ninjahisser/JJMP3/hardware/case.3mf

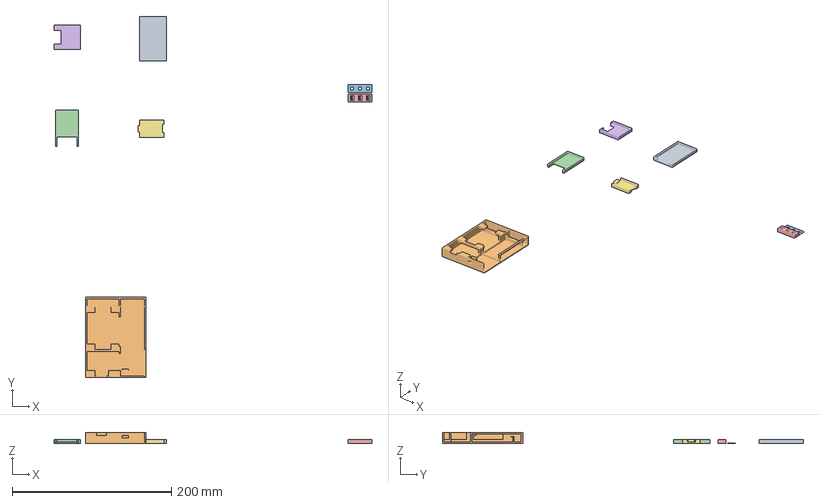
[picture p5: CAD file, 2026-11-09]
hardware/case.3mf
399.9 x 454.1 x 14.0 mm
case_esp32.stl
case_bottom.stl
case_ButtonsLid.stl
case_SD.stl
case_ButtonsRow.stl
case_display.stl
case_tp4056.stl
