ninjahisser/JJMP3/hardware/case_bottom.stl

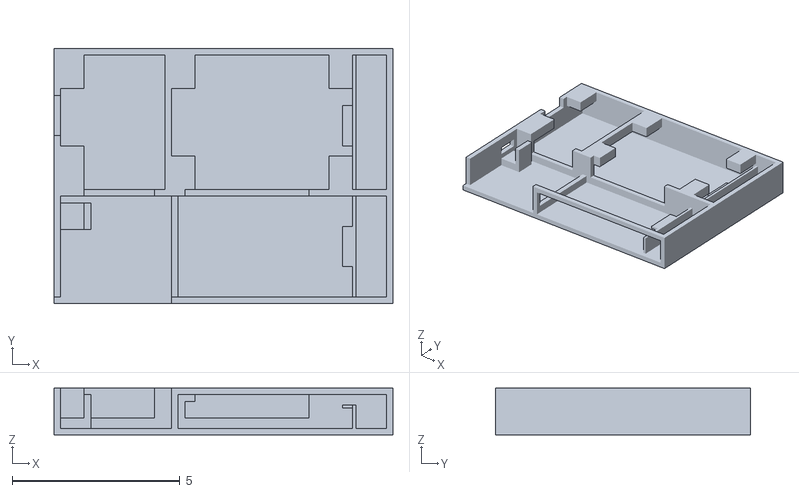
[picture p6: CAD file, 2026-11-09]
hardware/case_bottom.stl
10.1 x 7.60 x 1.40
