ninjahisser/JJMP3/hardware/case_tp4056.stl

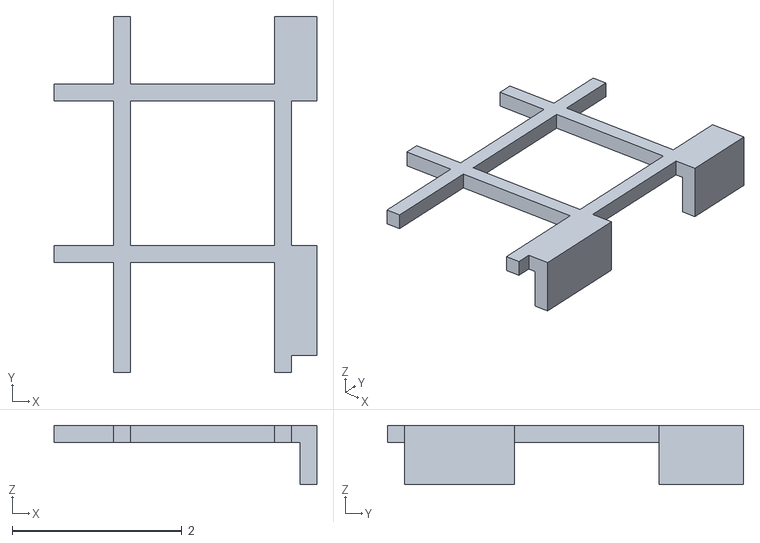
[picture p7: CAD file, 2026-11-09]
hardware/case_tp4056.stl
3.10 x 4.20 x 0.7
