ninjahisser/JJMP3/hardware/case_ButtonsRow.stl

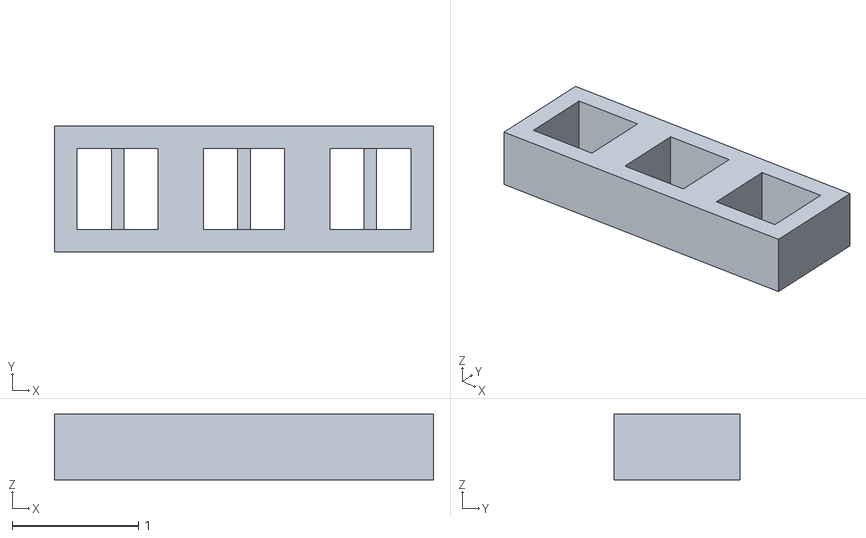
[picture p8: CAD file, 2026-10-25]
hardware/case_ButtonsRow.stl
3.00 x 1.00 x 0.52
