ninjahisser/JJMP3/hardware/case_ButtonsLid.stl

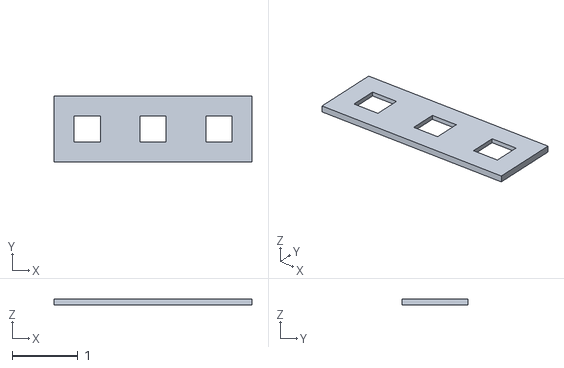
[picture p9: CAD file, 2026-10-24]
hardware/case_ButtonsLid.stl
3.00 x 1.00 x 0.09
