ninjahisser/JJMP3/hardware/case_SD.stl

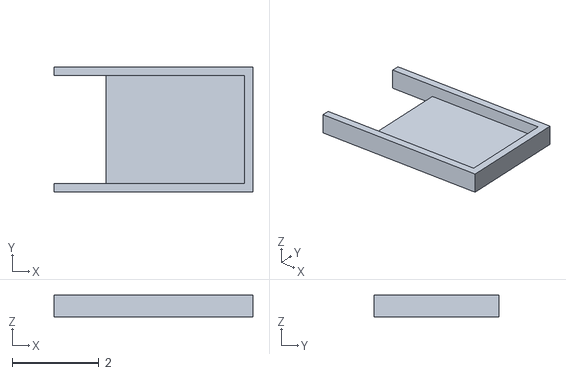
[picture p10: CAD file, 2026-10-21]
hardware/case_SD.stl
4.60 x 2.90 x 0.5
