ninjahisser/JJMP3/hardware/case_display.stl

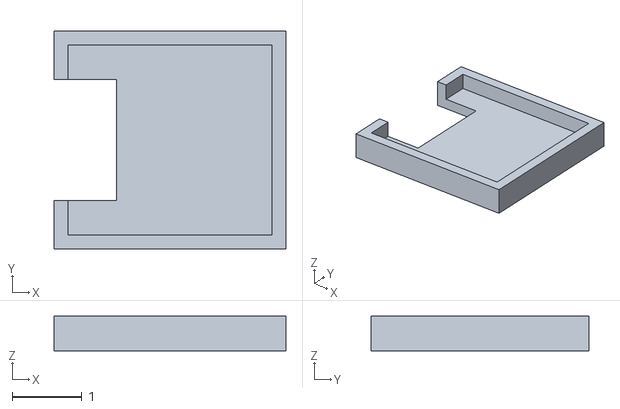
[picture p11: CAD file, 2026-10-21]
hardware/case_display.stl
3.33 x 3.13 x 0.5
