ninjahisser/JJMP3/hardware/case_esp32.stl

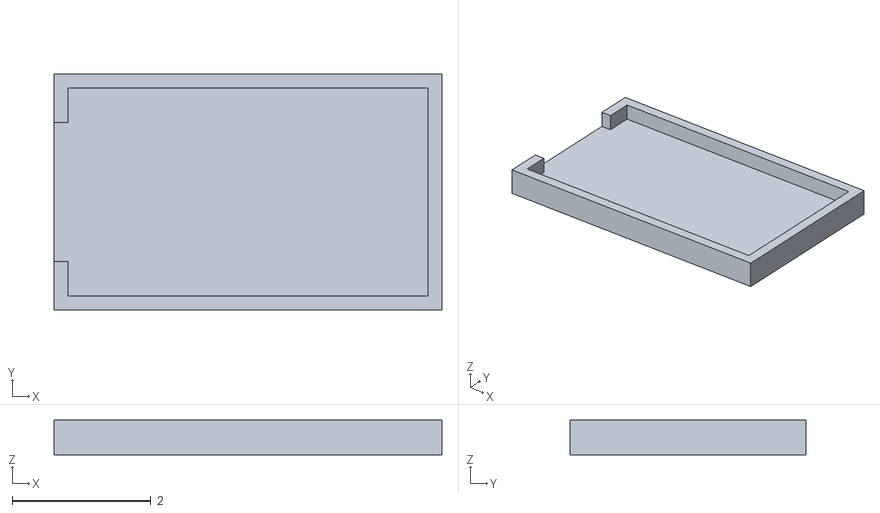
[picture p12: CAD file, 2026-10-21]
hardware/case_esp32.stl
5.60 x 3.40 x 0.5
