ninjahisser/JJMP3/(list of files, cad)

Other CAD files:
hardware/case.blend
