ninjahisser/JJMP3/todo.md

# Todo

Legend: ✅ checked by you and it works · 🔍 done, waiting for your review · ⬜ not done yet (reason in italics)

ik wil meerdere wifis kunnen opslaan gelijk een gsm

we moeten hebben: music player mode (normaal), spotify mode (spotify sync), en speaker mode (werkt als externe speaker met pc bv verbonden).

🔍 show battery percentage when playing on bluetooth. *Bottom right of Now Playing, when a battery is wired.*

⬜ Add audio even if its simple to all the games and UI. *Needs the speaker amplifier (ordered?) and the I2S audio code.*

⬜ on the device I should be able to add music to playlists and rename playlists etc like pc. *Not started.*

⬜ music playing should sync with the device, so playing a song, timeline etc is always the same and controls control both on both devices. *The app shows the player's state and the output switch hands over; full two-way sync is not done.*

🔍 when adding music and it shows a playlist, make it so I can select individual songs to add like a checkbox.

🔍 when I hover over teh app in the taskbar it should havce those controls like spotify does.

🔍 add karaoke mode in a tab. *Karaoke tab with synced lyrics, a saved timing offset per song, and a live search ("Wrong or missing lyrics? Search") to pick the right lyrics when the title doesn't match.* the device should also show the lyrics of the song. *Not done: needs the SD card.*
