ninjahisser/JJMP3/(commit log)

2026-10-18 JJMP3: ESP32 MP3 player firmware and desktop app
    - Firmware (firmware/jjmp3): SD card MP3 playback over Bluetooth A2DP,
    OLED now-playing screen with dithered cover art, one-button control,
    JSON protocol over USB serial and HTTP. Built as two images (music
    mode / Wi-Fi mode) because the ESP32 can't fit both radios in RAM.
    - Desktop app (app): imports YouTube and Spotify links, converts and
    uploads them to the player, playlists, playback control, live OLED
    mirror, Wi-Fi and Bluetooth setup. JJMP3.exe sets itself up on first run.
    - Wiring test sketches in firmware/tests.
2026-10-19 JJMP3 1.0.2: device OS, buttons, games, dark mode
    Player firmware 1.1.0:
    - iPod-style OS on the OLED: Now playing, Music, Playlists, Games, Settings
    (Bluetooth pairing, Wi-Fi scan / type a name, mode switch, About).
    - Five buttons (< P > and volume +/-) on D32 D4 D33 D13 D14; the app can
    press them remotely (btn command).
    - On-device keyboard: a character wheel driven by < P >.
    - Games: built-in Snake and a CHIP-8 player for .ch8 files in /games.
    - Playlists come from /playlists.tsv, written by the app.
    Desktop app 1.0.2:
    - Fix: Add songs on a playlist blanked the window (zustand selector loop);
    an error boundary now keeps a broken page from blanking the app.
    - Dark mode switch, saved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
    [config.h, games.h, input.h, jjmp3.ino, keyboard.h, library.h, os.h, protocol.h]
2026-10-19 Add Pibble Catch: catch the falling mulch
    A built-in game next to Snake: steer the pibble with < >, three misses and it's over, best score kept on the player.
2026-10-19 Battery indicator for a 3.7 V LiPo
    Firmware: reads the cell through a 2x100k divider on D34, shows a battery icon in the yellow band (blinks below 10 %), warns at 5 %, and sleeps when empty (wake with P). Hidden when nothing is wired. Level in Settings > About and in the status.
    App 1.0.3: battery level in the sidebar and on the Player page.
2026-10-19 Fix Bluetooth with modern earbuds: secure pairing, fresh re-pair
    The A2DP library defaults to legacy PIN pairing; earbuds like the Arctis GameBuds need Secure Simple Pairing, so the link never came up (stuck on idle). Enable SSP, clear old pairing keys when choosing headphones, record link events, and report 'refused' after three turned-down attempts. The app explains how to re-pair.
    [bt.h, os.h, protocol.h]
2026-10-24 Fix app not finding the Z0Ɛ player; larger Zen speech bubbles
    The app read serial replies as Latin-1 and only accepted the name JJMP3, so the renamed firmware never connected. Decode as UTF-8 and accept Z0Ɛ and JJMP3. Washington Zen bubbles may use four lines so the longest sleep-talk line fits.
    [zen.h]
2026-10-24 Fix player freezing while streaming: decoder task now yields
    The decoder task at higher priority never blocked while the ring drained, starving the main loop (USB, screen, buttons) whenever Bluetooth audio played. It now yields every pass at the same priority as loop().
    [player.h]
2026-10-24 Fix play rebooting the player; diagnose slow Bluetooth pulls
    Playing over Bluetooth ran the heap below the low-memory guard, so the player rebooted when play was pressed. Halve the PCM ring (4096 to 2048 frames), lower the decoder gate to match, raise the decoder task priority, set maximum Bluetooth TX power and add playback counters to the status reply (perf).
    Known: the Bluetooth stack only pulls about 0.6x real time from the player (210 pulls of 128 frames a second); the cause is not yet found.
    [bt.h, config.h, player.h, protocol.h]
2026-10-24 Add wiring diagram PDF (docs/bedrading.pdf) with its HTML source
    Three pages: signal wiring, power and battery, pin table and notes.
2026-10-24 Wiring PDF v2: every wire numbered, power rails, on/off switch, push-button close-ups, wire list
2026-10-24 Work through todo.md: themes, Games tab, search and picking, taskbar controls, world time
    App: calm green palette by default (plus paper and slate, each light/dark), pixel-heart icon, a pixel heart with particles when you click the background, Games on its own tab, brand Z0Ɛ, bloat texts removed, repaired playlist pages (App.tsx referenced missing components), add-music dialog can search by name, shows a lookup bar and has a tick box per song, taskbar thumbnail buttons (previous, play/pause, next).
    Player: Z0Ɛ drawn on the OLED (mirrored E glyph), battery percent on Now Playing, World time screen with summer time rules, Visualiser screen (loudness history), speaker pins reserved (D26 D25 D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
    [config.h, os.h, player.h, profile.h, ui.h]
2026-10-24 Save Seth game, karaoke tab, SD mount fallbacks, todo markers
    Player: Save Seth side-scroller (Zoe punches Steffe's goons in Kinepolis, floating *snort* *fart* *burp*), SD mounting tries slower SPI speeds and probes MISO, pintest command for checking GPIO wiring.
    App: Karaoke tab with synced lyrics from lrclib.net.
    todo.md: status markers (check = verified by you, magnifier = needs review, square = not done).
    [case.3mf, case.blend, case_ButtonsLid.stl, case_ButtonsRow.stl]
2026-10-25 Spotify mode (app page + player screen), lyrics timing offset and live lyrics search, themes, world time, games
    [case.blend]
2026-10-25 Spotify mode: fix cover art, player buttons over Wi-Fi
    [case.3mf, case.blend, case_ButtonsRow.stl]
2026-10-25 Firmware update over Wi-Fi (Player page button, /ota route)
    [case.blend]
2026-10-25 Window title: Z0Ɛ
    [case.blend, case_ButtonsRow.stl]
2026-11-02 Wi-Fi: find the player as z0e.local, probe hosts in parallel with a hard timeout, fix fractional upload timeout
2026-11-02 SD diagnostics (report, remount, two pin sets), sync pauses without a card, updated wiring PDF with SD page
2026-11-02 i2c_scan diagnostic for the OLED (pull-up check, swapped pins, search other pins); try the standard SD pins first
    [config.h, protocol.h, sdcard.h]
2026-11-02 OLED: SDA on D21 or the spare pin RX2/D16, whichever the display answers on; drop the alternative SD pin set
2026-11-02 Wiring PDF: spare SDA pin for the OLED
2026-11-02 Wiring: OLED SDA on RX2 (D16), left GND pin marked as not making contact
2026-11-02 Buttons: > on D12, + on D14, - on D33; button test command; wiring PDF and README updated
2026-11-02 Buttons: > on D13
2026-11-02 Wiring PDF: page 6 with the DFRobot MAX98357 board as it looks and the 4 ohm 3 W speaker, amplifier VCC naming
2026-11-02 Speaker: switching it off ends its task too, so all its memory goes back to Bluetooth
2026-11-02 Playback: decoded frames go through a stage into the ring and the decoder feeds a whole frame in one go (no dropouts when Bluetooth pulls in bursts); dropout and pull-timing counters in status
2026-11-03 Bluetooth: drop the bitpool cap (the internal SBC encoder ignores it) and report the bitpool the headphones agreed
2026-11-03 Bluetooth stutter fix: stage decoded frames in the decoder's own buffer (frees 4.6 KB, so the stack can queue two 4 KB packets per tick instead of one: full rate instead of ~58%); start the stream 1 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
    [bt.h, player.h, protocol.h, speaker.h]
2026-11-08 Battery: 'battery' command reports raw D34 readings, to diagnose a missing battery level
    [protocol.h]
2026-11-08 Battery: also look for the divider on D35, VP and VN; About shows the pin and voltage when no battery is found; 'battery' command reads all four pins
2026-11-09 Downloads without compiling: the app ships the player firmware and esptool and installs it over USB (also on a bare ESP32) or Wi-Fi; firmware/release.ps1 packs it and makes a single image for browser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
